dirkt68/pl2-recorder/README.md

#Automated Recorder Project
##Texas Tech University PL2
