dirkt68/pl2-recorder/report/main_report.tex

\documentclass[UTF8, 12pt]{article}

% PACKAGES
\usepackage{geometry}
\usepackage{graphicx}
\usepackage{setspace}
\usepackage{indentfirst}
\usepackage{hyperref}
\usepackage{amsmath}
\usepackage{csvsimple}
\usepackage[T1]{fontenc}
\usepackage[nottoc,notlot,notlof]{tocbibind}
\usepackage[style=ieee,sorting=none,backend=biber]{biblatex}

% DOCUMENT SETTINGS
% PAPER SETTINGS
\geometry{letterpaper,
          left=1in,
          right=1in,
          top=1in,
          bottom=1in}

% IMAGE DIRECTORY
\graphicspath{{images/}}

% OTHER SETTINGS
\renewcommand*\contentsname{Table of Contents} % change table of contents name
\renewcommand{\thefigure}{\Roman{figure}}
\addbibresource{refs.bib}

% TITLE DEFINITIONS
\title{Project Lab 2\\\large Midterm Report}
\author{Dirk Thieme\\R11636727\\Texas Tech University}
\date{October 2022}

% MAIN DOCUMENT
\begin{document}
\maketitle
\pagenumbering{gobble}
\newpage
\pagenumbering{arabic}
% \spacing{1.25}
\spacing{2}

% ABSTRACT
\begin{abstract}
    This paper describes the current progress of the Automated Recorder Project. While the requirements of the project will be discussed more in further sections, the general goal is to automate the playing of a recorder using a Raspberry Pi, which will be able to play any song as given to it through a flash drive. This project is being developed by Dirk Thieme, Mason Hadley, Jake Kiedasch, and Mariano Arce.
\end{abstract}

\newpage
\tableofcontents

\newpage
\listoffigures

% \newpage
% \listoftables

\newpage
\section{Introduction}
    The original premise of the Automated Recorder Project is to play a grade school recorder using a Raspberry Pi. The recorder should be able to play eight notes, and would be able to play a select number of songs chosen by the instructor of the course and a local area elementary school teacher. The recorder apparatus should be able to play in front of an elementary school class.

    While the premise of the project was enough of a challenge, this project aims to go above and beyond the original scope by allowing the recorder to play all 27 notes within its capability and by allowing the user to dynamically chose the desired song to play with an MP3 file. To allow the recorder to play all notes, certain holes must only be covered halfway, a technique known as leaking and pinching \cite{rec_wiki}. To be able to play any MP3 file provided, the software will be able to process the song on demand and convert the sound wave into a collection of frequencies which correspond to notes. These notes will be automatically converted into notes that the recorder can play.

    The brain of the apparatus is the Raspberry Pi 4B (furthermore Pi), a single-board computer which executes the code and controls the hardware. The Pi is powered using a quad core 64-bit ARM-Cortex A72 running at 1.5GHz \cite{ras_pi} which brings enough power to the table in order to complete the challenging digital signal processing required. The GPIO pins are also utilized to be able to control the hardware which actuates the recorder.

    The recorder is physically controlled through the use of six solenoids, three servo motors, and three compounded fans. Five of the solenoids cover and uncover the main holes, and three of the servos perform the pinching of the holes which require multiple positions. The one other solenoid opens and closes the main labium, which stops the recorder from playing to play rests. The solenoids require 12V power, while the servos and Pi require 5V power. The Pi only outputs 5V at 16mA on the GPIO pins \cite{ras_pi}, therefore a circuit has been designed in order to be able to actuate the solenoids while not burning out the GPIO pins. To power the entire setup, a 12V, 150W power supply will be able to accept AC wall power, which it can then send to a custom made power distribution PCB, which incorporates a 12V-5V buck converter and the various high power outputs, along with the solenoid circuits. 

    While the structure of the software is rather simple, the implementation is exceedingly complex, and requires immense amounts of research and assistance to complete. The software is not currently finalized, however in its current state it ingests an MP3 file then converts it into a WAV file. The WAV file bytestream is parsed into its proper values, then its time-domain signal is broken up into bins which are individually processed using a Fast Fourier Transform into their frequency-domain counterpart. The magnitudes of each bin are then calculated, which reveal the peak frequency of the bin, corresponding to the note at that time period. These notes are then converted into their recorder playable counterparts, which will then be played for the correct amount of time.

\newpage
\section{Body}
    The current state of this project is comprised of the following components, the Software, a Python codebase which consists of the MP3 ingestion, the WAV parsing, the Fast Fourier Transform, and the musical outputs, and the Hardware, which consists of the recorder itself, the control devices, the air production, and the Pi which runs the whole thing.

\subsection{Software}
\subsubsection{Flow of Control Chart}
    \begin{figure}[h]
        \centering
        
        \caption{Main Software Flowchart}
        \label{fc}
    \end{figure}
    As shown in Figure \ref{fc}, this flowchart is the initial path which the code takes. The Nextion workflow has not yet been implemented, as it is unnecessary in determining if the main important code is functional, which itself cannot be yet determined without the construction of the apparatus. As stated previously, the code currently begins at the top if the "Main Code Workflow" section, however in the future it will begin at the "Nextion Screen Workflow". The Nextion screen is a touch screen with a built in microcontroller, which will be used to take user input and send it over to the Pi for actual use. 

\subsubsection{MP3 Ingestion}
    The bulk of the MP3 ingestion is performed by the software \textbf{ffmpeg}, originally developed by Fabrice Bellard and Bobby Bingham on December 20, 2000 \cite{ffmpeg}. 
    \begin{figure}[h]
        \centering
        
        \caption{ffmpeg Command and Output Implementation}
        \label{ff_code}
    \end{figure}
    Shown in Figure \ref{ff_code}, certain command flags must be used upon executing the program in order to ensure proper output \cite{ffmpeg}. Some of the commands are less important, such as "-sn", which ignores subtitles or "-vn", which ignores any video streams (although this does implicate the software could feasibly process video data). Other commands are a necessity for proper output, such as "-f" and "wav", which sets the output format to a WAV file, and "-acodec" and "pcm\_s16le", which sets the output codec correctly. The most important flag there is "pipe:1" which outputs the WAV bytestream to the stdout, instead of dumping the output to a file. All of the output is contained in the variable conveniently named "output." Output consists of two properties, stderr and stdout. As stated above, stdout contains the bytestream of the output, but for debugging purposes stderr is useful as it contains the output of the command.

\subsubsection{WAV Parsing and Processing}
    Now that a WAV "file" has been obtained, work must be done in order to ascertain the correct values. The codec which was used to process the song is known as PCM, and the actual values that were output were unsigned 16-bit little-endian chunks. If one simply tried to read the bytes as they were, nothing but gibberish would be produced. This is because the bytes are little-endian, meaning the lower 8-bits are placed ahead of the upper 8-bits, effectively reversing the number in memory. As an example, take the decimal number \(2,500\). Its representation in a 16-bit hexadecimal is \(0x09C4\). Storing this value into contiguous memory locations would result in the following:
    \begin{equation*}
        0xC4 \to 0x09 \to ...
    \end{equation*}
    Attempting to get this value by only reading from left to right would return the number \(0xC409\), which is the decimal number \(50,185\), the incorrect value.

    To combat this, the Python package struct is used, as the programmer can tell the struct unpacking object what format to retrieve the bytestream as. This is done using format strings, in this case the string "<L". The < symbol tells the object the bytes will be little-endian, and the L tells the object to pack them into a 4-byte number \cite{struct}. This initial reading of the file allows the program to find the necessary sections of the file to read from.

    WAV files consist of a standardized structure \cite{wav}. They begin with a 44-76 byte header, depending on the WAV file creator. The program parses this header to either find the "fmt" section or the "data" section. The "fmt" section contains useful file information, such as number of channels, sample rate, and codec type. The "data" section contains, quite simply, all the actual song data. The program parses the "fmt" section for the information it needs to later process the "data" section. This is shown in below in Figure \ref{wav_code}.
    \begin{figure}[h!]
        \centering
        
        \caption{WAV Processing Code}
        \label{wav_code}
    \end{figure}
    After this is complete, the variable "parsedSignal" is returned to the main program, which contains the actual waveform, and is then ready for further processing.

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

    A prerequisite of this operation is that the provided signal must be a power of 2, which is where the time savings come from \cite{fft_wiki}. In order to this, the length of the signal is checked using the code in Figure \ref{check2_fig}, which compares the bits of the number and the number minus one. If the number is a power of 2, the result of ANDing them together would be 0, otherwise it would be any other number.
    \begin{figure}[h]
        \centering
        
        \caption{Function to Calculate if Number is a Power of 2}
        \label{check2_fig}
    \end{figure}
    Because the sample rate of the songs is 44.1kHz, and the windows of time are 100ms long, the number is not a power of 2, therefore the next highest power of 2 must be found and the signal must be extended to the new number.

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

    Once those notes are found, those notes are rounded up and down into the actual playable notes on the recorder. This is done by comparing the note to a list of notes which the reorder can physically play.

\subsection{Hardware}
\subsubsection{The Recorder}
    As the main goal of the project is to play a recorder automatically, the most important facet of the hardware is the recorder itself. The YRS-24B is the instrument used. This recorder is fairly standard, and is tuned in C. Figure \ref{rec} depicts the recorder.
    \begin{figure}[h]
        \centering
        
        \caption{The Yamaha YRS-24B Recorder}
        \label{rec}
    \end{figure}
    This specific recorder can play notes from C5 to D7, which is a range of 27 total notes. Playing is accomplished by blowing into the mouthpiece and covering and uncovering the holes as required by each note and octave. This recorder also has a rotating end piece, which makes it easier to articulate with rigid mechanical components.
    \newpage
\subsubsection{Airflow}
    The recorder is a woodwind instrument \cite{rec_wiki}, and being so it requires airflow to play. The proper airflow requirement is around 0.1 to 1 liter per second \cite{rec_info}, therefore while the speed of the air is less important, generating the correct airflow is necessary for good sound. To produce a balance between too much and too little airflow, three blower fans are mounted in series in order to control the flow. This is shown in Figure \ref{fan_fig}.
    \begin{figure}[h]
        \centering
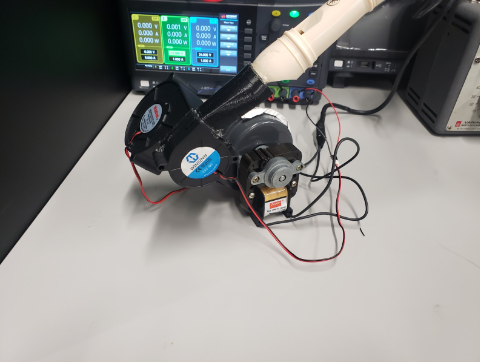
[picture p27: report/images/fans.png]
        
        \caption{Compound Fan Setup}
        \label{fan_fig}
    \end{figure}
    The larger fan is a Dayton 1TDN1A, a 115V AC fan that can output 13CFM \cite{fan_info}. This blower motor provides the majority of the airflow, which is then pressurized using two 75x30mm blower fans, whose job it is only force the air through at a higher pressure. 

    Controlling the air is done through a solid-state relay and the Raspberry Pi, as experimenting with different airflow configurations showed that all the high notes can be played with all three fans blowing, and the lower half of the spectrum can be played with the big fan turned off. This makes controlling airflow easy, instead of using a more complicated solution such as a PWM signal. This combination of fans has proven effective at pushing the perfect amount of air through the recorder, as any less faded out before hitting the high notes, and any more caused shrill shrieking sounds.

    \subsubsection{Solenoids and Servos}
    While the correct amount of air now properly flows through the recorder, only a single note would play if the holes are not used. To do this, a series of five solenoids and three servos is used. The five solenoids are meant to actuate the holes facing upwards, where a fully open or fully closed state is acceptable. For the holes that require variably closed and open states, the three servos are positioned under the recorder to close and open them as needed. A 3D model of the system is shown below in Figure \ref{rec_set_fig}.
    \begin{figure}[h]
        \centering
        
        \caption{3D Recorder Model}
        \label{rec_set_fig}
    \end{figure} 

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

    The 5V is generated with a TPS566247DRLR, a 5V, 6A switch mode power supply. This voltage is output to four connectors, three for the servos and one for the Pi. The rest of the raw 12V power is routed to the six solenoid drivers and two fan drivers, which is the same circuit as the solenoid driver but lacking a flyback diode. The board is a four layer design, with a stackup consisting of signal-ground-12V-signal, measuring 1.6mm thick. The board is 100x60mm, with four M3 bolt holes for mounting to the apparatus. 
    \subsubsection{Computational Power}
    \begin{figure}[h]
        \centering
        
        \caption{The Raspberry Pi Model 4B}
    \end{figure}
    The Pi used is a 4GB model with a quad core ARM processor. To aid the speed of the FFT execution for songs, the process will be multithreaded using Python's builtin threading library. GPIO pins 4, 17, 27, 22, 5, 6, 13, 19 are connected to the various solenoid and servo outputs. To provide the least overhead possible, instead of installing a full-fledged operating system, a headless version of Raspbian is used in combination with SSH for access.
\section{Conclusion}
    As of the due date of this paper, the project is currently unfinished. That being the case, the most challenging facets, the software and airflow, have been taken care of and are ready for integration with the remainder of the parts. Some of the main components still needed are the PCB, which also needs to be assembled, a final setup of the Raspberry Pi, full assembly of the entire system, and some builtin songs in the case of no user provided songs. The code is also currently written for only MP3s, so it must be adapted to either user MP3s or to play the hard-coded songs. In addition, a touchscreen must still be implemented for user interfacing, along with a USB insertion detection script. As this project has remained fairly ahead of schedule, considerations are also being made for a MIDI interface, which can plug directly into the Pi and be used to play music on the fly, for example using a keyboard and playing a recorder note. There are also plans to get the solenoid connectors laser cut out of aluminum, and to 3D print the necessary enclosures and holders.

% \newpage
\section{Appendix}
\subsection{GANTT Chart and Budget}
    \begin{figure}[h]
        \centering
        
        \caption{Current Budget}
        \label{bud_fig}
    \end{figure}
    \begin{figure}[h]
        \centering
        
        \caption{Current GANTT Chart Progress}
        \label{gan_fig}
    \end{figure}
    As shown in Figures \ref{bud_fig} and \ref{gan_fig},the budget and GANTT are progressing well. The budget is currently sitting at around 63\% used, which is about how much of the semester has currently passed, keeping the budget on track. As shown in the GANTT chart, the majority of the items to be completed have either been completely finished or at least halfway done.
\subsection{Safety and Ethics}
    Special considerations must be thought of safety wise, as this project is meant to be presented to a classroom of elementary schoolers. Because of this, care has been taken to ensure AC power is never exposed anywhere a student might touch, and that the touchscreen access in general should only be relegated to the teacher of the classroom or the people of the lab group. It is also important to consider volume levels, as overblowing the recorder could cause a loud, sharp noise which could hurt a student. The maximum airflow of the fans has been found, and it is within an acceptable range as to not hurt any hearing. The ethical ramifications stem from the fact that human musicians are already paid very little for their talents, so developing an automated system to play an instrument might lead to less jobs. However, this machine will never be able to be as versatile and talented as a real person playing, so I think it is safe to say this shouldn't hurt any chances.

\newpage
\printbibliography

\end{document}
