dirkt68/pl2-recorder/pcb/main_board/bomPowerPCB.xlsx

DigiKey Part # | Item Description | Quantity | Unit cost | Calculated Cost |  |  | AUTOBOM --- Revision 2 --- 5/6/2015
296-TPS566247DRLRTR-ND | TPS56624 5V 6A Buck Converter | 3 | $2.00 | $6.00
F8848-ND | 55088 15A 24V Toggle Switch | 1 | $14.12 | $14.12
1276-1804-2-ND | 10uF 1206 X7R 25V Ceramic Cap | 6 | $0.26 | $1.56 |  | Notes:
1276-CL32B226KPJVPNETR-ND | 22uF 1210 X7R 10V Ceramic Cap | 12 | $0.74 | $8.88 |  |  | BOM => Bill of Materials
1276-1006-2-ND | 0.1uF 0603 X7R 25V Ceramic Cap | 3 | $0.10 | $0.30 |  |  | Part # must be exact, mouser part number or company-specific, no direct links
541-1299-2-ND | LIHLP4040DZER2R2M1 2.2uH Inductor | 3 | $1.58 | $4.74 |  |  | The Item Description allows you to find your parts more easily,especially in bulk
RNCP0603FTD11K0TR-ND | 11k 0603 Resistor | 3 | $0.10 | $0.30 |  |  | Unit cost is not required, but it helps determine what parts are expensive
A130566TR-ND | 220k 1206 Resistor | 3 | $0.30 | $0.90
1292-WR06X153JTLTR-ND | 15k 0603 Resistor | 6 | $0.10 | $0.60 |  |  | [NAME, Lab#] is inserted in your description automatically upon buying
YAG1235TR-ND | 100k 0603 Resistor | 3 | $0.34 | $1.02 | Total: | $61.10
RNCP0805FTD10K0TR-ND | 10k 0805 Resistor | 24 | $0.10 | $2.40
RNCP0805FTD1K00TR-ND | 1k 0805 Resistor | 24 | $0.10 | $2.40
B220-FDITR-ND | B220 -13 -F Schottky Diode | 18 | $0.50 | $9.00
DMG2302UK-7DITR-ND | DMG2302U7 MOSFET | 24 | $0.37 | $8.88
 |  | 1 | $0.00 | $0.00
 |  | 1 | $0.00 | $0.00
 |  | 1 | $0.00 | $0.00
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
 |  | 1 | $0.00 | $0.00
 |  | 1 | $0.00 | $0.00
 |  | 1 | $0.00 | $0.00
 |  | 1 | $0.00 | $0.00
 |  | 1 | $0.00 | $0.00
 |  | 1 | $0.00 | $0.00
 |  | 1 | $0.00 | $0.00
 |  | 1 | $0.00 | $0.00
 |  | 1 | $0.00 | $0.00
 |  | 1 | $0.00 | $0.00
 |  | 1 | $0.00 | $0.00
 |  | 1 | $0.00 | $0.00
