dirkt68/pl2-recorder/pcb/main_board/mainPCB/output/test-powerPCB.step

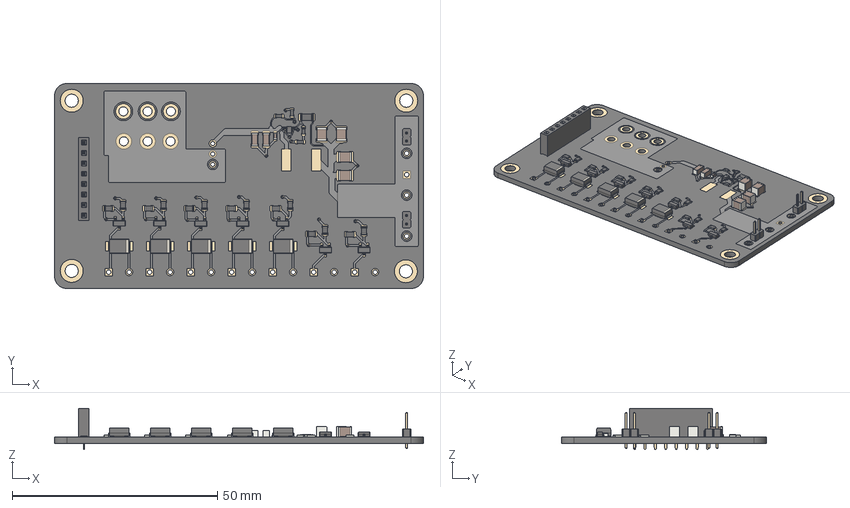
[picture p30: CAD file, 2022-10-24]
pcb/main_board/mainPCB/output/test-powerPCB.step
90.0 x 50.0 x 10.1 mm
Local_CS_ff63
Pcb_ff63
PCB_Sketch_ff63
topPads_ff63
topTracks_ff63
topZones_ff63
botPads_ff63
botTracks_ff63
Q2_SOT_23_66daab9062c2 x 7
R1_R_0603_1608Metric_254c457e904d x 4
R13_R_0805_2012Metric_10041c72cd7b x 14
C5_C_1210_3225Metric_b1d6679e2841 x 4
D4_D_SMB_db361c2c0c27 x 5
C2_C_1206_3216Metric_5ba43bb4664a x 2
J4_PinHeader_1x02_P200mm_Vertical_e5aff077508f x 2
C3_C_0603_1608Metric_50d9c3c40fb4
J5_PinSocket_1x08_P254mm_Vertical_cb378dc3b516
U1_SOT_563_cd4c4e379f35
R5_R_1206_3216Metric_c213e6bdc7fc
