dirkt68/pl2-recorder/pcb/main_board/mainPCB/powerPCB.step

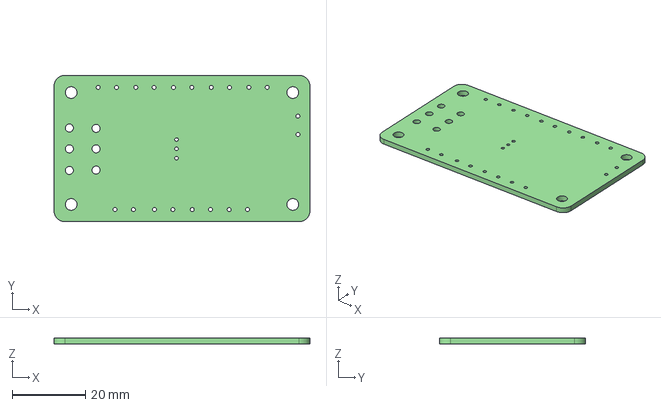
[picture p31: CAD file, 2022-10-03]
pcb/main_board/mainPCB/powerPCB.step
70.0 x 40.0 x 1.60 mm
