dirkt68/pl2-recorder/pcb/main_board/mainPCB/output/board_model.FCStd

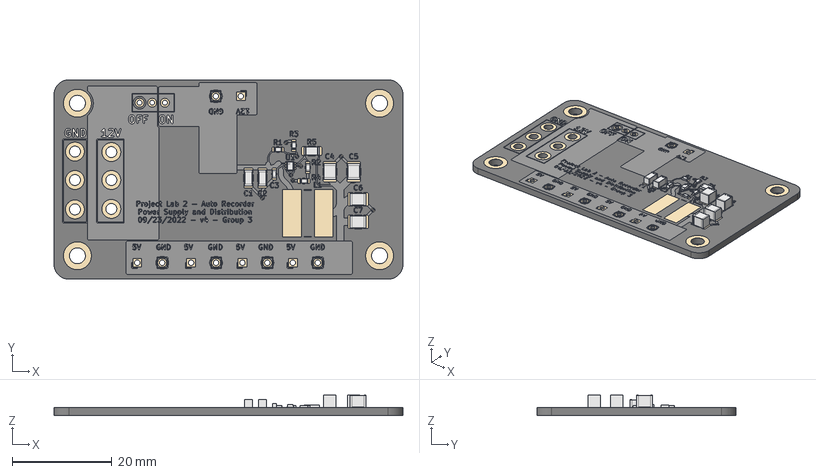
[picture p32: CAD file, 2022-10-03]
pcb/main_board/mainPCB/output/board_model.FCStd
70.0 x 40.0 x 4.17 mm
Pcb_ff63
topPads_ff63
topTracks_ff63
topZones_ff63
botPads_ff63
botTracks_ff63
botZones_ff63
botSilks_57cf
topSilks_5a1b
R1_R_0603_1608Metric_254c457e904d x 4
C5_C_1210_3225Metric_b1d6679e2841 x 4
C2_C_1206_3216Metric_5ba43bb4664a x 2
C3_C_0603_1608Metric_50d9c3c40fb4
U1_SOT_563_cd4c4e379f35
R5_R_1206_3216Metric_c213e6bdc7fc
