dirkt68/pl2-recorder/(list of files, cad)

Other CAD files:
pcb/main_board/mainPCB/output/test.FCStd
pcb/main_board/mainPCB/output/powerPCB-B_Silkscreen.dxf
pcb/main_board/mainPCB/output/powerPCB-F_Silkscreen.dxf
