dirkt68/pl2-recorder/code/v2/scales/Chord Note Choice Test.PNG

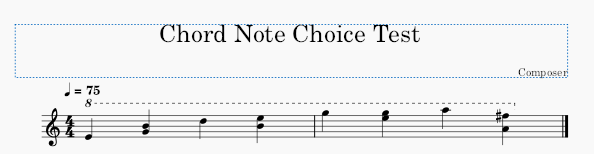
code/v2/scales/Chord Note Choice Test.PNG
