dirkt68/pl2-recorder/code/v2/scales/Chromatic Freq Test.PNG

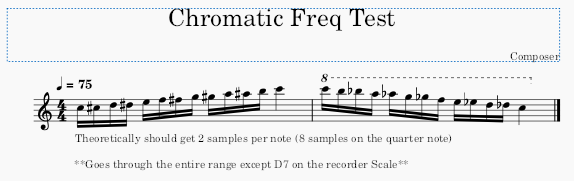
code/v2/scales/Chromatic Freq Test.PNG
