dirkt68/pl2-recorder/code/v2/scales/Hot Cross Buns Test.PNG

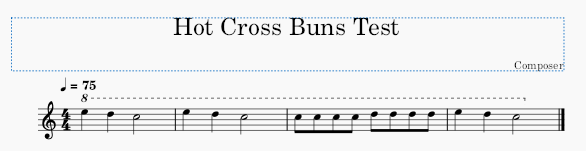
code/v2/scales/Hot Cross Buns Test.PNG
