dirkt68/pl2-recorder/code/v2/scales/Timing Test 1.PNG

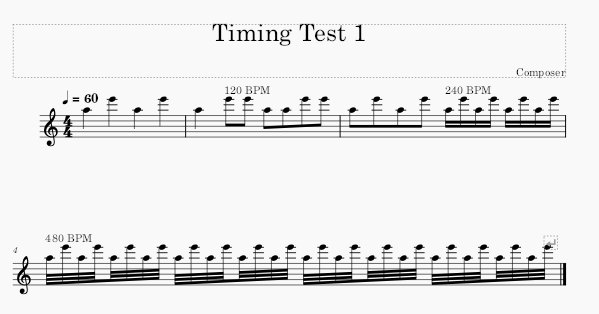
code/v2/scales/Timing Test 1.PNG
