dirkt68/pl2-recorder/code/flowchart/flowchartv1.pdf

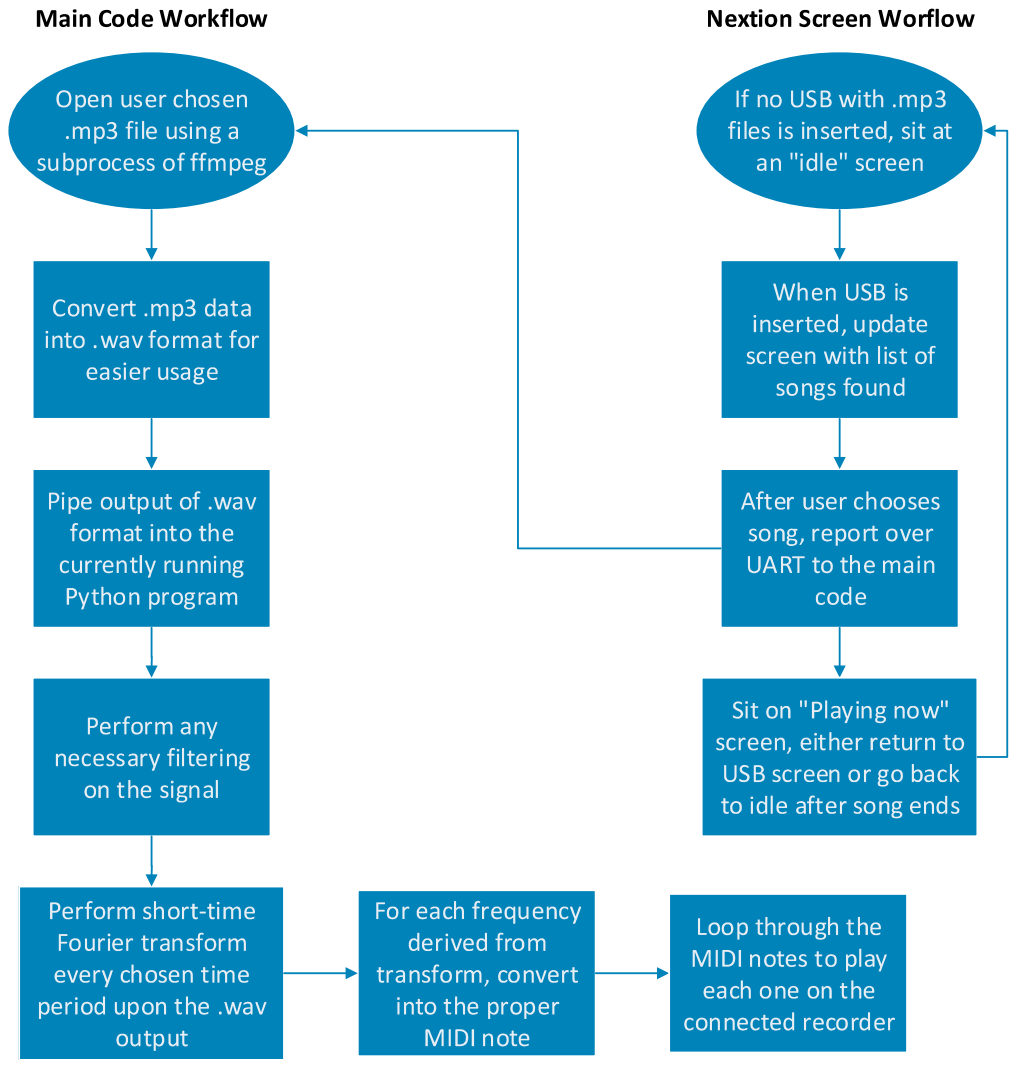
[picture p38: page 1]
