dirkt68/pl2-recorder/pcb/main_board/mainPCB/powerPCB.kicad_pcb

## KiCad design pcb/main_board/mainPCB/powerPCB.kicad_pcb (2022-10-24)

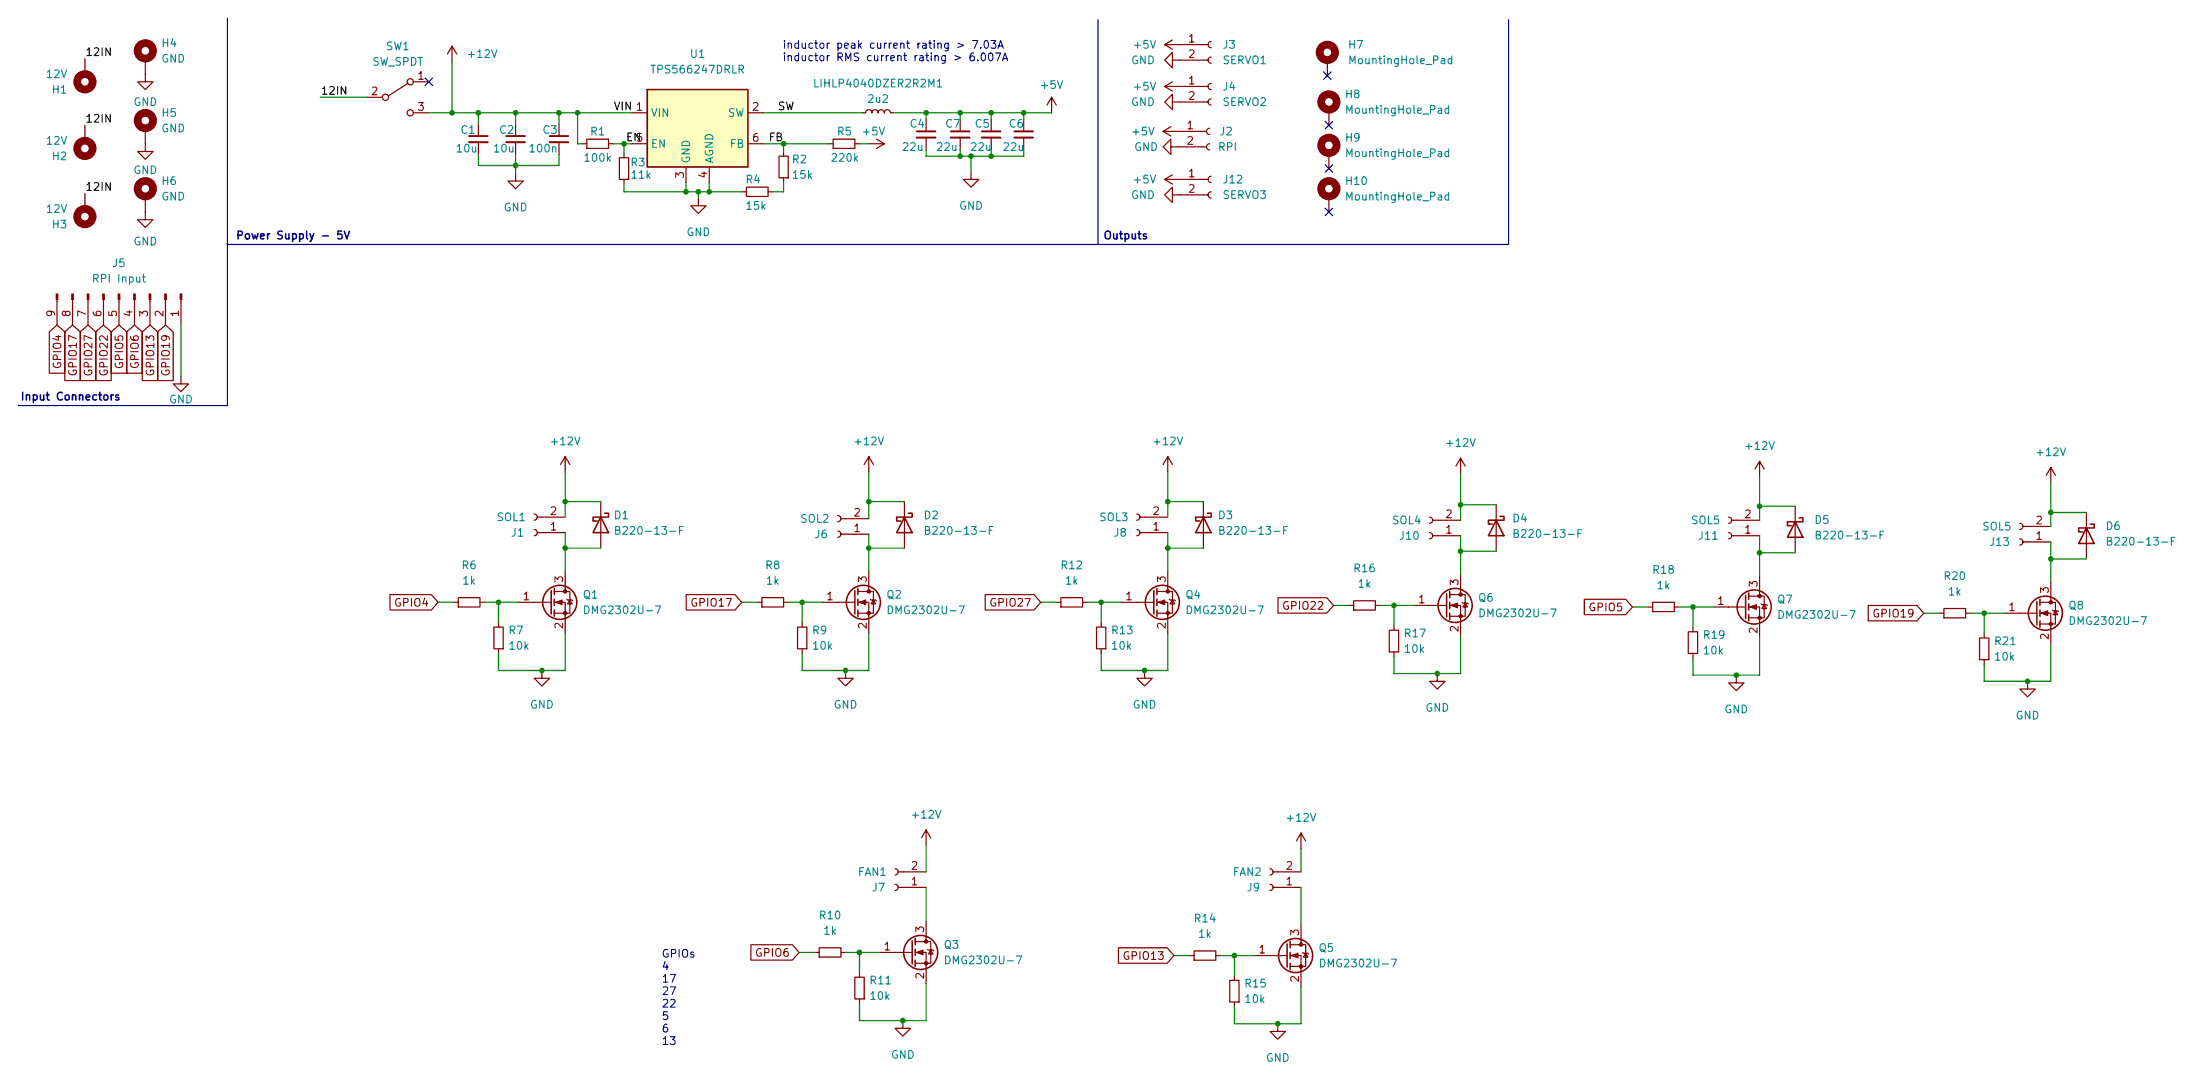
[picture p39: schematic powerPCB.kicad_sch, Main Power Supply/Drivers]

Parts:
C1, C2: 10u; C_1206_3216Metric
C3: 100n; C_0603_1608Metric
C4, C5, C6, C7: 22u; C_1210_3225Metric
D1, D2, D3, D4, D5, D6: B220-13-F; D_SMB
H1, H2, H3: 12V; MountingHole_2.2mm_M2_DIN965_Pad
H4, H5, H6: GND; MountingHole_2.2mm_M2_DIN965_Pad
H7, H8, H9, H10: MountingHole_Pad; MountingHole_3.2mm_M3_DIN965_Pad
J1: SOL1; PinHeader_1x02_P5.00mm
J2: RPI; PinHeader_1x02_P5.00mm
J3: SERVO1; PinHeader_1x02_P5.00mm
J4: SERVO2; PinHeader_1x02_P5.00mm
J5: RPI Input; PinHeader_1x09_P2.54mm_Vertical
J6: SOL2; PinHeader_1x02_P5.00mm
J7: FAN1; PinHeader_1x02_P5.00mm
J8: SOL3; PinHeader_1x02_P5.00mm
J9: FAN2; PinHeader_1x02_P5.00mm
J10: SOL4; PinHeader_1x02_P5.00mm
J11, J13: SOL5; PinHeader_1x02_P5.00mm
J12: SERVO3; PinHeader_1x02_P5.00mm
LIHLP4040DZER2R2M1: 2u2; L_Vishay_IHLP-4040
Q1, Q2, Q3, Q4, Q5, Q6, Q7, Q8: DMG2302U-7; SOT-23
R1: 100k; R_0603_1608Metric
R2, R4: 15k; R_0603_1608Metric
R3: 11k; R_0603_1608Metric
R5: 220k; R_1206_3216Metric
R6, R8, R10, R12, R14, R16, R18, R20: 1k; R_0805_2012Metric
R7, R9, R11, R13, R15, R17, R19, R21: 10k; R_0805_2012Metric
SW1: SW_SPDT; remote switch
U1: TPS566247DRLR; SOT-563

Connections:
+5V: C4.1, C5.1, C6.1, C7.1, J2.1, J3.1, J4.1, J12.1, LIHLP4040DZER2R2M1.2, R5.2
+12V: C1.1, C2.1, C3.1, D1.1 (K), D2.1 (K), D3.1 (K), D4.1 (K), D5.1 (K), D6.1 (K), J1.2, J6.2, J7.2, J8.2, J9.2, J10.2, J11.2, J13.2, R1.1, SW1.3 (C), U1.1 (VIN)
/12IN: H1.1, H2.1, H3.1, SW1.2 (B)
/EN: R1.2, R3.2, U1.5 (EN)
/FB: R2.2, R5.1, U1.6 (FB)
/SW: LIHLP4040DZER2R2M1.1, U1.2 (SW)
GND: C1.2, C2.2, C3.2, C4.2, C5.2, C6.2, C7.2, H4.1, H5.1, H6.1, J2.2, J3.2, J4.2, J5.1, J12.2, Q1.2 (S), Q2.2 (S), Q3.2 (S), Q4.2 (S), Q5.2 (S), Q6.2 (S), Q7.2 (S), Q8.2 (S), R3.1, R4.1, R7.1, R9.1, R11.1, R13.1, R15.1, R17.1, R19.1, R21.1, U1.3 (GND), U1.4 (AGND)
GPIO4: J5.9, R6.1
GPIO5: J5.5, R18.1
GPIO6: J5.4, R10.1
GPIO13: J5.3, R14.1
GPIO17: J5.8, R8.1
GPIO19: J5.2, R20.1
GPIO22: J5.6, R16.1
GPIO27: J5.7, R12.1
unnamed: D1.2 (A), J1.1, Q1.3 (D)
unnamed: D2.2 (A), J6.1, Q2.3 (D)
unnamed: D3.2 (A), J8.1, Q4.3 (D)
unnamed: D5.2 (A), J11.1, Q7.3 (D)
unnamed: D6.2 (A), J13.1, Q8.3 (D)
unnamed: J7.1, Q3.3 (D)
unnamed: J9.1, Q5.3 (D)
unnamed: Q1.1 (G), R6.2, R7.2
unnamed: Q2.1 (G), R8.2, R9.2
unnamed: Q3.1 (G), R10.2, R11.2
unnamed: Q4.1 (G), R12.2, R13.2
unnamed: Q5.1 (G), R14.2, R15.2
unnamed: Q6.1 (G), R16.2, R17.2
unnamed: D4.2 (A), J10.1, Q6.3 (D)
unnamed: Q7.1 (G), R18.2, R19.2
unnamed: Q8.1 (G), R20.2, R21.2
unnamed: R2.1, R4.2

Notes on the sheet:
Power Supply - 5V
Input Connectors
Outputs
inductor peak current rating > 7.03A inductor RMS current rating > 6.007A
GPIOs 4 17 27 22 5 6 13

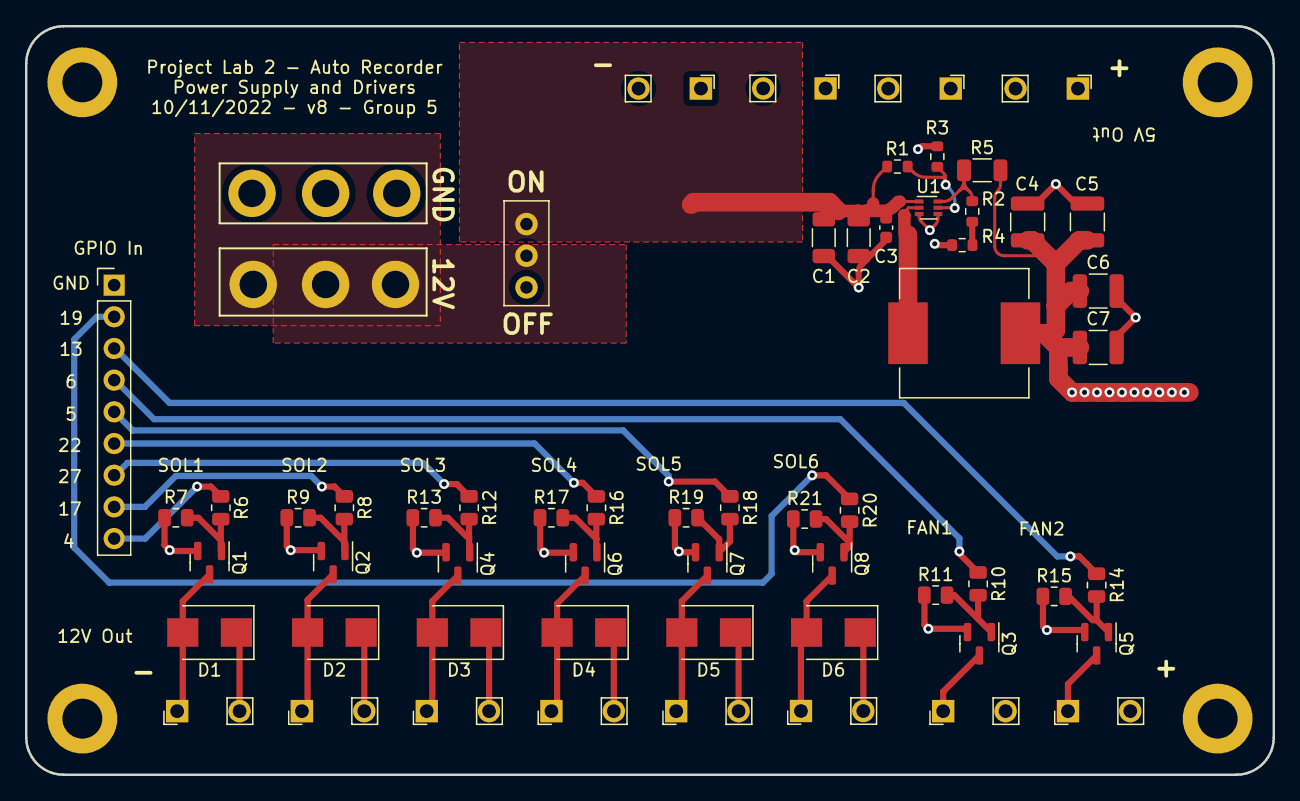
[picture p40: board powerPCB.kicad_pcb from above]

Board: 4 copper layers, 100.0 x 60.0 mm, 68 parts (0 on the bottom side), 32 nets.
