dirkt68/pl2-recorder/code/v2/constants.py

# USER LIBRARY (For Hardcoded Songs)
from hardcodeSignal import HardcodeSong
from enum import Enum

# all possible frequencies that would be from a song
freq_to_notes = {16.35: 'C0', 
                 17.32: 'C#0', 
                 18.35: 'D0', 
                 19.45: 'D#0', 
                 20.6: 'E0', 
                 21.83: 'F0', 
                 23.12: 'F#0', 
                 24.5: 'G0', 
                 25.96: 'G#0', 
                 27.5: 'A0', 
                 29.14: 'A#0', 
                 30.87: 'B0', 
                 32.7: 'C1', 
                 34.65: 'C#1', 
                 36.71: 'D1', 
                 38.89: 'D#1', 
                 41.2: 'E1', 
                 43.65: 'F1', 
                 46.25: 'F#1', 
                 49: 'G1', 
                 51.91: 'G#1', 
                 55: 'A1', 
                 58.27: 'A#1', 
                 61.74: 'B1', 
                 65.41: 'C2', 
                 69.3: 'C#2', 
                 73.42: 'D2', 
                 77.78: 'D#2', 
                 82.41: 'E2', 
                 87.31: 'F2', 
                 92.5: 'F#2', 
                 98: 'G2', 
                 103.83: 'G#2', 
                 110: 'A2', 
                 116.54: 'A#2',
                 123.47: 'B2',
                 130.81: 'C3',
                 138.59: 'C#3', 
                 146.83: 'D3', 
                 155.56: 'D#3', 
                 164.81: 'E3', 
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


usable_notes =      ["C5",    
                     "C#5",   
                     "D5",    
                     "D#5",    
                     "E5",    
                     "F5",    
                     "F#5",    
                     "G5",    
                     "G#5",    
                     "A5",    
                     "A#5",    
                     "B5",    
                     "C6",    
                     "C#6",    
                     "D6",    
                     "D#6",
                     "E6",
                     "F6",
                     "F#6",
                     "G6",   
                     "G#6",  
                     "A6",   
                     "A#6",    
                     "B6",   
                     "C7",
                     "C#7",    
                     "D7"
                     ]

######### Mason's Edition 10/30/22: Hardcoded Song Bank #########

Hot_Cross_Buns = HardcodeSong("Hot Cross Buns", 120, 
["B5","A5","G5","B5","A5","G5","-","G5","-","G5","-","G5","-","G5","-","A5","-","A5","-","A5","-","A5","-","B5","A5","G5"], 
[1.0, 1.0, 2.0, 1.0, 1.0, 1.75, 0.25, 0.25, 0.25, 0.25, 0.25, 0.25, 0.25, 0.25, 0.25, 0.25, 0.25, 0.25, 0.25, 0.25, 0.25, 0.25, 0.25, 1.0, 1.0, 2.0])

Gently_Sleep = HardcodeSong("Gently Sleep", 110, 
["G5","A5","B5","A5","G5","A5","G5","A5","B5","A5","B5","G5","-","G5","A5","B5","A5","G5","A5","G5","A5","B5","A5","B5","G5"], 
[1.0, 1.0, 2.0, 1.0, 1.0, 2.0, 1.0, 1.0, 2.0, 1.0, 1.0, 1.75,0.25, 1.0, 1.0, 2.0, 1.0, 1.0, 2.0, 1.0, 1.0, 2.0, 1.0, 1.0, 2.0])

Roll_Along = HardcodeSong("Mary Had a Little Lamb", 140, 
["B5","A5","G5","A5","B5","-","B5","-","B5","A5","-","A5","-","A5","B5","-","B5","-","B5","-","B5","A5","G5","A5","B5","-","B5","-","B5","A5","-","A5","B5","A5","G5"], 
[1.0, 1.0, 1.0, 1.0, 0.75, 0.25, 0.75, 0.25, 2.0, 0.75, 0.25, 0.75, 0.25, 2.0, 0.75, 0.25, 0.75, 
0.25, 1.75, 0.25, 1.0, 1.0, 1.0, 1.0, 0.75, 0.25, 0.75, 0.25, 2.0, 0.75, 0.25, 1.0, 1.0, 1.0, 2.0])

Its_Raining = HardcodeSong("It's Raining", 125,
["G5","-","G5","E5","A5","G5","E5","-","E5","G5","E5","A5","G5","E5","G5","-","G5","E5","-",
"E5","A5","G5","-","G5","E5","-","E5","A5","G5","-","G5","-","G5","E5","-","E5","A5","G5","E5"], 
[0.75, 0.25, 2.0, 1.0, 1.0, 2.0, 0.75, 0.25, 1.0, 2.0, 1.0, 1.0, 2.0, 2.0, 0.75, 0.25, 1.0, 0.75, 0.25, 
0.5, 0.5, 0.75, 0.25, 1.0, 0.75, 0.25, 0.5, 0.5, 0.4, 0.1, 0.4, 0.1, 1.0, 0.75, 0.25, 0.5, 0.5, 2.0, 1.0])

Old_Mcdonald = HardcodeSong("Old McDonald Had a Farm", 120, 
["G5","-","G5","-","G5","D5","E5","-","E5","D5","B5","-","B5","A5","-","A5","G5","D5","G5","-","G5","-","G5","D5","E5","-","E5","D5","B5","-",
"B5","A5","-","A5","G5","D5","-","D5","G5","-","G5","-","G5","D5","-","D5","G5","-","G5","-","G5","-","G5","-","G5","-","G5","-","G5","-","G5",
"-","G5","-","G5","-","G5","-","G5","-","G5","-","G5","-","G5","-","G5","-","G5","-","G5","D5","E5","-","E5","D5","B5","-","B5","A5","-","A5","G5"], 
[0.75, 0.25, 0.75, 0.25, 1.0, 1.0, 0.75, 0.25, 1.0, 2.0, 0.75, 0.25, 1.0, 0.75, 0.25, 1.0, 3.0, 1.0, 0.75, 0.25, 1.0,
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

# note setup :: note/octave = (sol1, sol2, sol3, sol4, sol5, servo1, servo2, servo3)
# solenoids are SOL_OPEN/SOL_CLOSED, servos are SERVO_CLOSED, SERVO_HALF, SERVO_OPEN
