dirkt68/pl2-recorder/(commit log)

2022-09-20 first upload, most of code finished
    [powerPCB.kicad_pcb, powerPCB.kicad_sch]
2022-10-03 updated folders
    [BOM-powerPCB.csv, board_model.FCStd, bomPowerPCB.xlsx, powerPCB-B_Silkscreen.dxf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]
2022-10-24 updated code, half of report, and PCB
    [BOM-powerPCB.csv, board_model.FCStd, bomPowerPCB.xlsx, powerPCB-B_Silkscreen.dxf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]
2022-10-25 finished report
    [notes.csv]
2022-12-07 more transfer
    [notes.csv]
